biodigitalmatter/digital_signal_24V_to_5V_breakout/3d_models/430450400.stp

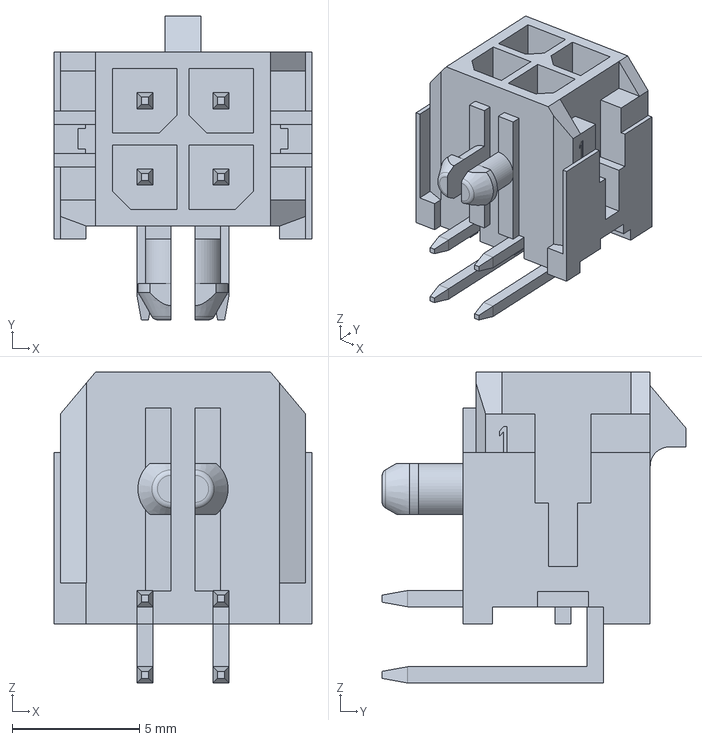
[picture p1: CAD file, 2023-02-16]
3d_models/430450400.stp
10.2 x 11.9 x 12.2 mm
