biodigitalmatter/digital_signal_24V_to_5V_breakout/3d_models/430450412.stp

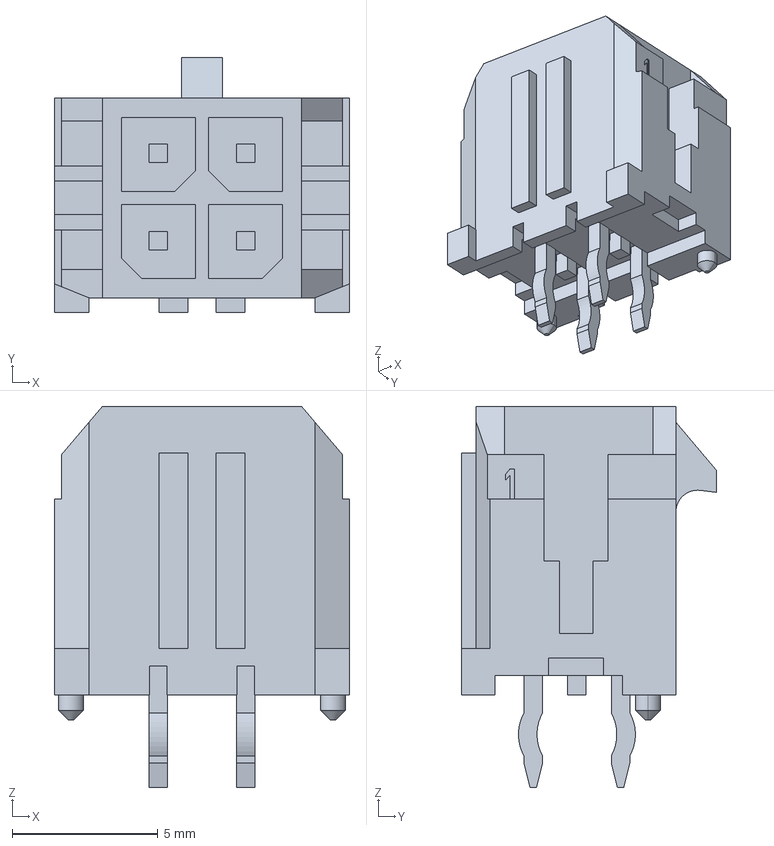
[picture p2: CAD file, 2023-02-16]
3d_models/430450412.stp
10.2 x 8.77 x 13.1 mm
