biodigitalmatter/digital_signal_24V_to_5V_breakout/(commit log)

2023-02-16 wip new design
    [430450400.stp, 430450412.stp, digital_signal_24V_to_5V_breakout.kicad_pcb, digital_signal_24V_to_5V_breakout.kicad_sch]
2023-02-16 prep-ed for order
    [digital_signal_24V_to_5V_breakout.kicad_pcb]
2023-02-16 all components on same side again
    [digital_signal_24V_to_5V_breakout.kicad_pcb]
2023-02-16 fix missing annotation
    [digital_signal_24V_to_5V_breakout.kicad_pcb]
2023-04-06 4x opto couplers
    [digital_signal_24V_to_5V.kicad_sch, digital_signal_24V_to_5V_breakout.kicad_pcb, digital_signal_24V_to_5V_breakout.kicad_sch]
2023-04-06 cleanup project footprint library
2023-04-06 missed save, this is version sent to jlcpcb
    [digital_signal_24V_to_5V_breakout.kicad_sch]
2023-06-13 added hierachial pins for inclusion in fdm_3dp_setup
    [digital_signal_24V_to_5V_breakout.kicad_pcb, digital_signal_24V_to_5V_breakout.kicad_sch]
2023-06-13 missed hierachical pins for pwr and gnd
    [digital_signal_24V_to_5V_breakout.kicad_sch]
